taiyipan/mechatronics_project/(commit log)

2021-11-22 code for simple pass and stop signals with MPU6050 sensor
2021-12-01 Demo for MPU indicating for led position
    Arduino with Mpu using its DMP to get roll, pitch, yaw. And use LED to indicate the position
2021-12-01 driver code
2021-12-02 buggy prototype without bluetooth
    [Interpreter.cpp, Interpreter.h, prototype.ino]
2021-12-03 magnetic compass demo
2021-12-04 added interrupt button and reset buttons
2021-12-04 added missing sender raio setup code
    [sender.ino]
2021-12-05 more bug fixes and fixes
    [receiver.ino]
2021-12-06 added local button feature to receiver side
